krutikdg/deskClock/BOM.csv

Component | Quantity | Price/Unit (USD) | Purpose | Purchase Link
ESP32 DevKit V1 (30-pin) | 1 | 4.5 | Main controller with WiFi for time sync and weather and GitHub data | https://robocraze.com/products/esp32-development-board-with-cp2102-wifi-bluetooth-dual-core-30-pin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
2.4 Inch SPI TFT Display Module 240x320 (ILI9341) | 1 | 7.5 | Shows the clock and all the screens | https://robu.in/product/2-4-inch-spi-interface-240x320-touch-screen-tft-display-module/
BME280 I2C Temperature Humidity Pressure Sensor Module | 1 | 5.7 | Measures room temperature and humidity and air pressure | https://robu.in/product/smartelex-bme280-atmospheric-sensor-breakout-board/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
BH1750 (GY-302) Ambient Light Sensor Module | 1 | 1.2 | Dims the display backlight automatically at night | https://robocraze.com/products/gy-302-bh1750-light-intensity-module?variant=42268132016352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
HC-SR501 PIR Motion Sensor Module | 1 | 1.6 | Wakes the screen when someone is at the desk | https://www.google.com/aclk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
Passive Buzzer 12mm | 1 | 1.6 | Plays alarm and timer tones | https://www.google.com/search?ibp=oshop&q=product&biw=756&bih=798&dpr=2
BC547 NPN Transistor (Pack of 20) | 1 | 1.6 | Switches the buzzer so the ESP32 pin is not overloaded | https://www.google.com/search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
1K Ohm 1/4W Resistors (Pack of 10) | 1 | 0.07 | Base resistor for the buzzer transistor | https://quartzcomponents.com/products/1k-ohm-1-4-watt-resistor
6x6x5mm Tactile Push Button Switch (Pack of 10) | 1 | 0.21 | Two buttons to change screens and start or stop timers | https://www.google.com/search?q=6x6x5mm+Tactile+Push+Button+Switch+(Pack+of+10)&sourceid=chrome
Micro-USB Data Cable 1m | 1 | 0.41 | Powers the clock and uploads the code | https://robu.in/product/usb-to-micro-usb-cable-wire-1m-for-nodemcu/
5V 1A USB Power Adapter | 1 | 2.03 | Powers the clock from a wall socket | https://robu.in/product/orange-5v-1a-power-supply-with-5-5mm-dc-plug-adapter/
830 Point Breadboard | 1 | 0.73 | Testing the circuit before soldering | https://robu.in/product/mb102-830-points-solderless-prototype-pcb-breadboard-high-quality/
Jumper Wires Kit (M-M and M-F and F-F) | 1 | 1.68 | Connections between the boards during testing | https://www.google.com/aclk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
7x9 cm Universal PCB Prototype Board (Single Sided) | 1 | 0.52 | Mounts the buzzer transistor and resistor circuit permanently | https://www.google.com/search?sourceid=chrome
eSUN PLA Matte Deep Black 1.75mm Filament | 1 | 13.70 | 3D printing the case in black | https://www.google.com/aclk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
