krutikdg/deskClock/CAD/Desk_Clock(STEP).step

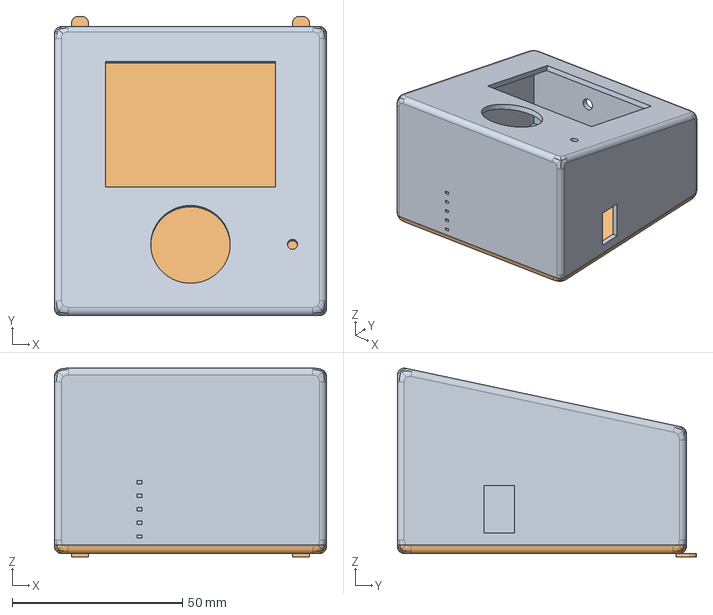
[picture p1: CAD file, 2026-11-02]
CAD/Desk_Clock(STEP).step
80.0 x 88.0 x 55.5 mm
