krutikdg/deskClock/CAD/clock_lid.stl

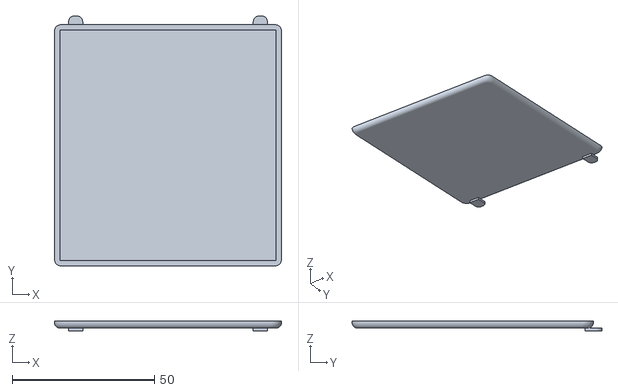
[picture p2: CAD file, 2026-11-02]
CAD/clock_lid.stl
80.0 x 88.0 x 3.50
