krutikdg/deskClock/CAD/clock_case.stl

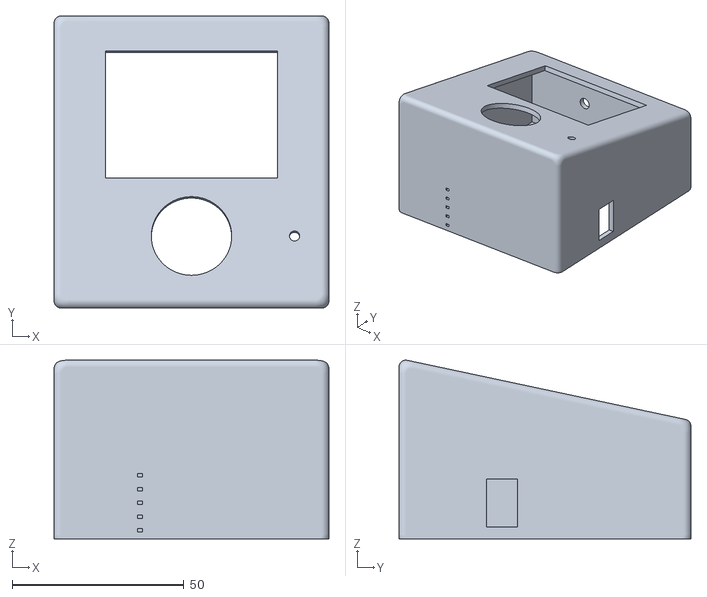
[picture p3: CAD file, 2026-11-02]
CAD/clock_case.stl
80.0 x 85.0 x 52.0
