krutikdg/deskClock/(list of files, cad)

Other CAD files:
CAD/Desk_Clock(f3d).f3d
