krutikdg/deskClock/(commit log)

2026-11-02 Added code and CAD
    [Desk_Clock(STEP).step, Desk_Clock(f3d).f3d, clock_case.stl, clock_lid.stl]
2026-11-02 added BOM
    [BOM.csv]
2026-11-04 Add duplicate components and update BOM
    Updated BOM.csv to add duplicate entries for Passive Buzzer and BC547 NPN Transistor, and added 6x6x5mm Tactile Push Button Switch.
    [BOM.csv]
